VuLinh011218/LedCube8x8x8/Hardware/Image/C_25.png

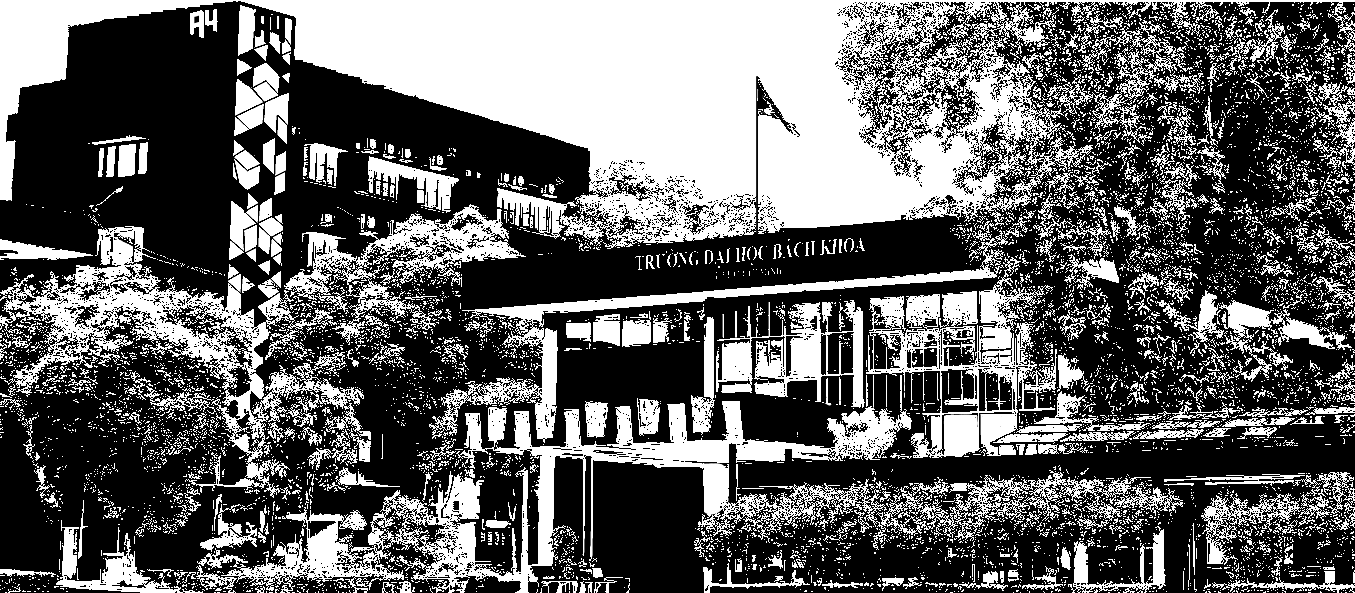
Hardware/Image/C_25.png
