VuLinh011218/LedCube8x8x8/Hardware/Image/PIF_WHITE.png

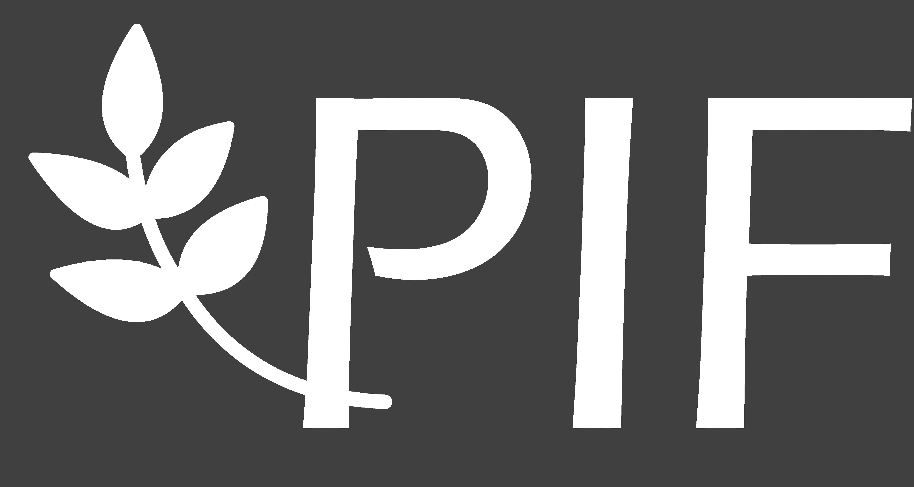
Hardware/Image/PIF_WHITE.png
