VuLinh011218/LedCube8x8x8/Hardware/Image/ImageToStl.com_7d02fde578674ff1ba44a5747493c69b/Logo_H_Bach_Khoa-HCMUT2.dxf

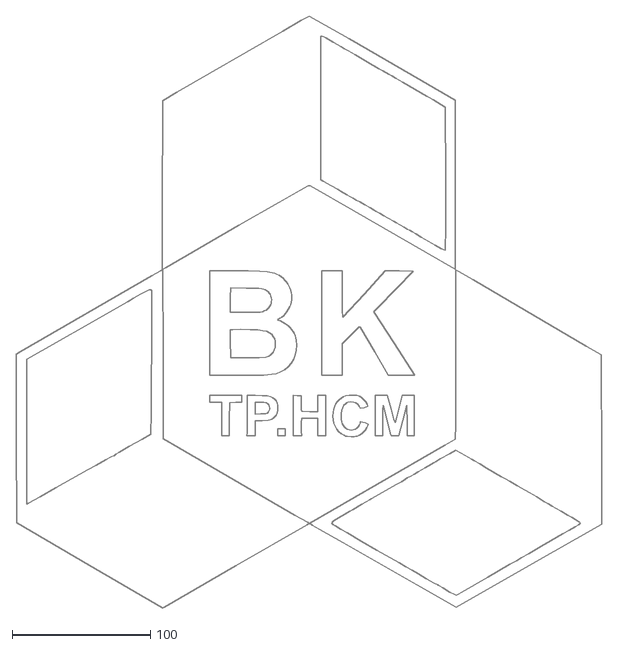
[picture p65: CAD file, 2026-07-12]
Hardware/Image/ImageToStl.com_7d02fde578674ff1ba44a5747493c69b/Logo_H_Bach_Khoa-HCMUT2.dxf
422.7 x 427.5
