VuLinh011218/LedCube8x8x8/Hardware/Image/ImageToStl.com_7d02fde578674ff1ba44a5747493c69b/ImageToStl.com_Logo_H_Bach_Khoa-HCMUT2_bottom.dxf

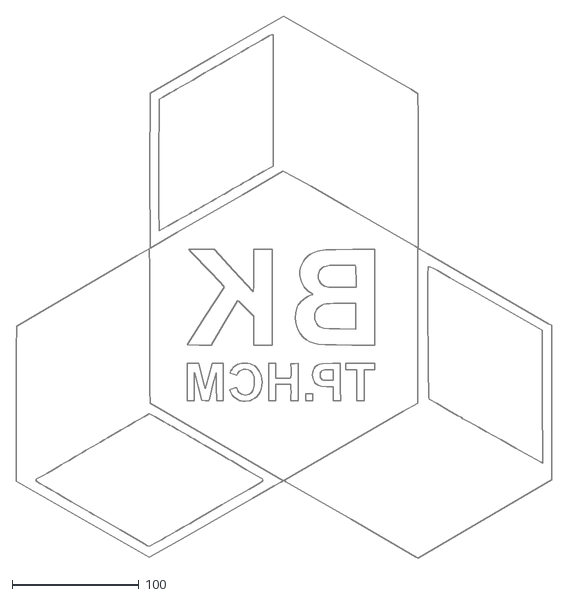
[picture p66: CAD file, 2026-07-12]
Hardware/Image/ImageToStl.com_7d02fde578674ff1ba44a5747493c69b/ImageToStl.com_Logo_H_Bach_Khoa-HCMUT2_bottom.dxf
422.7 x 427.6
