VuLinh011218/LedCube8x8x8/Hardware/Image/ImageToStl.com_7d02fde578674ff1ba44a5747493c69b/logo5.dxf

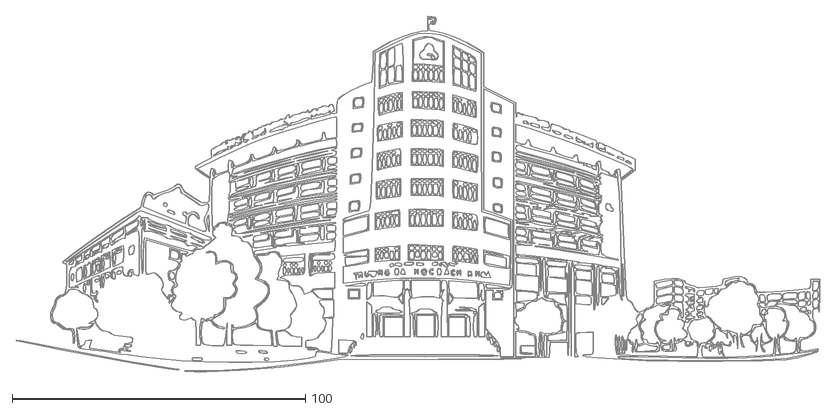
[picture p67: CAD file, 2026-07-12]
Hardware/Image/ImageToStl.com_7d02fde578674ff1ba44a5747493c69b/logo5.dxf
274.1 x 121.4
