VuLinh011218/LedCube8x8x8/Hardware/Image/ImageToStl.com_7d02fde578674ff1ba44a5747493c69b/ImageToStl.com_PIF_WHITE.dxf

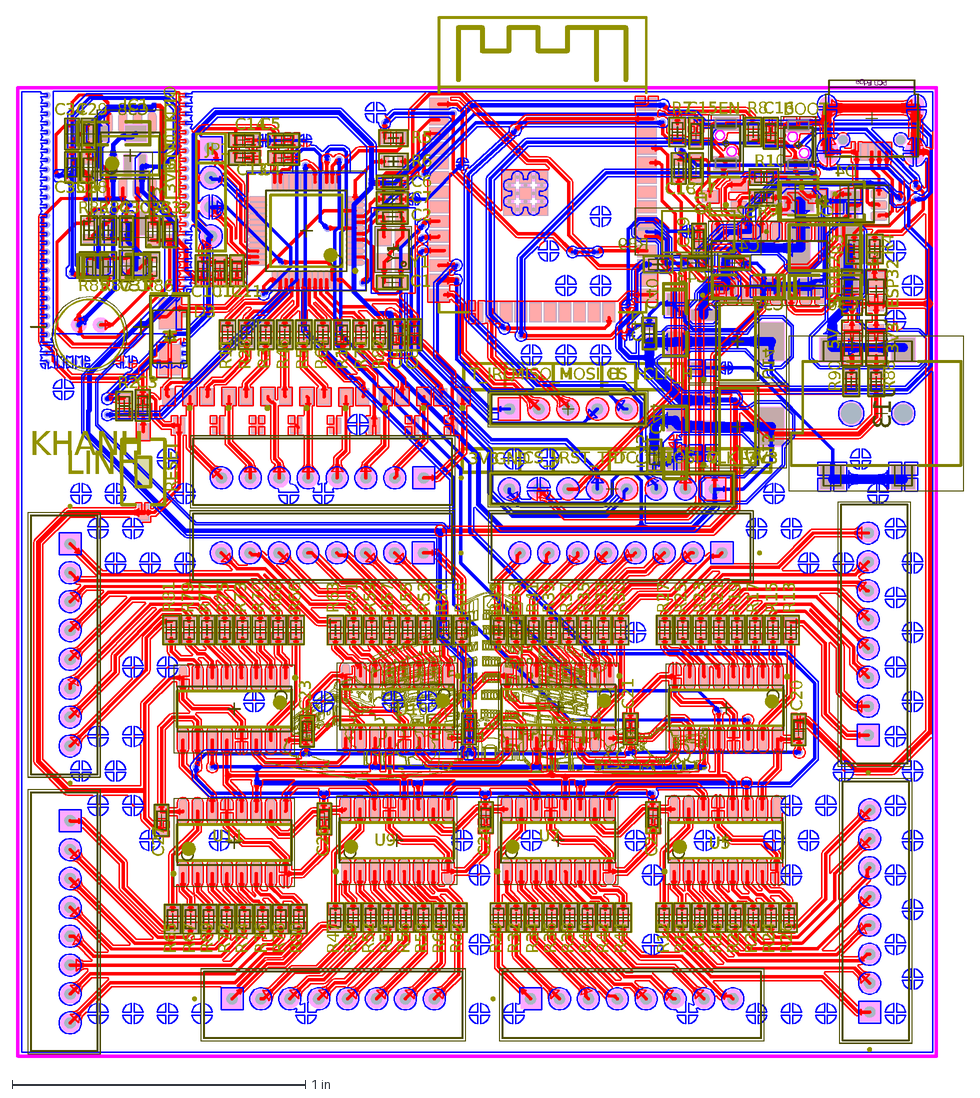
[picture p68: CAD file, 2026-07-12]
Hardware/Image/ImageToStl.com_7d02fde578674ff1ba44a5747493c69b/ImageToStl.com_PIF_WHITE.dxf
ESP32
GND
S2
R89
C43
C35
C34
C33
C32
C5
C4
Y1
U15
U14
U13
RST_TFT
U11
U10
U9
CS_V
U7
MOSI_V
U5
MOSI_H
DIO
RESET
R90
R88
R87
R86
R85
R84
R83
R82
R81
R80
R79
R78
R77
R76
R75
R74
R73
R72
R71
R70
R69
R68
R67
R66
R65
R64
R63
R62
R61
R60
R59
R58
R57
R56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
