VuLinh011218/LedCube8x8x8/Hardware/Schematic_PDF/Ledcube_8x8x8.pdf

A A

# PA0-WKUP 10

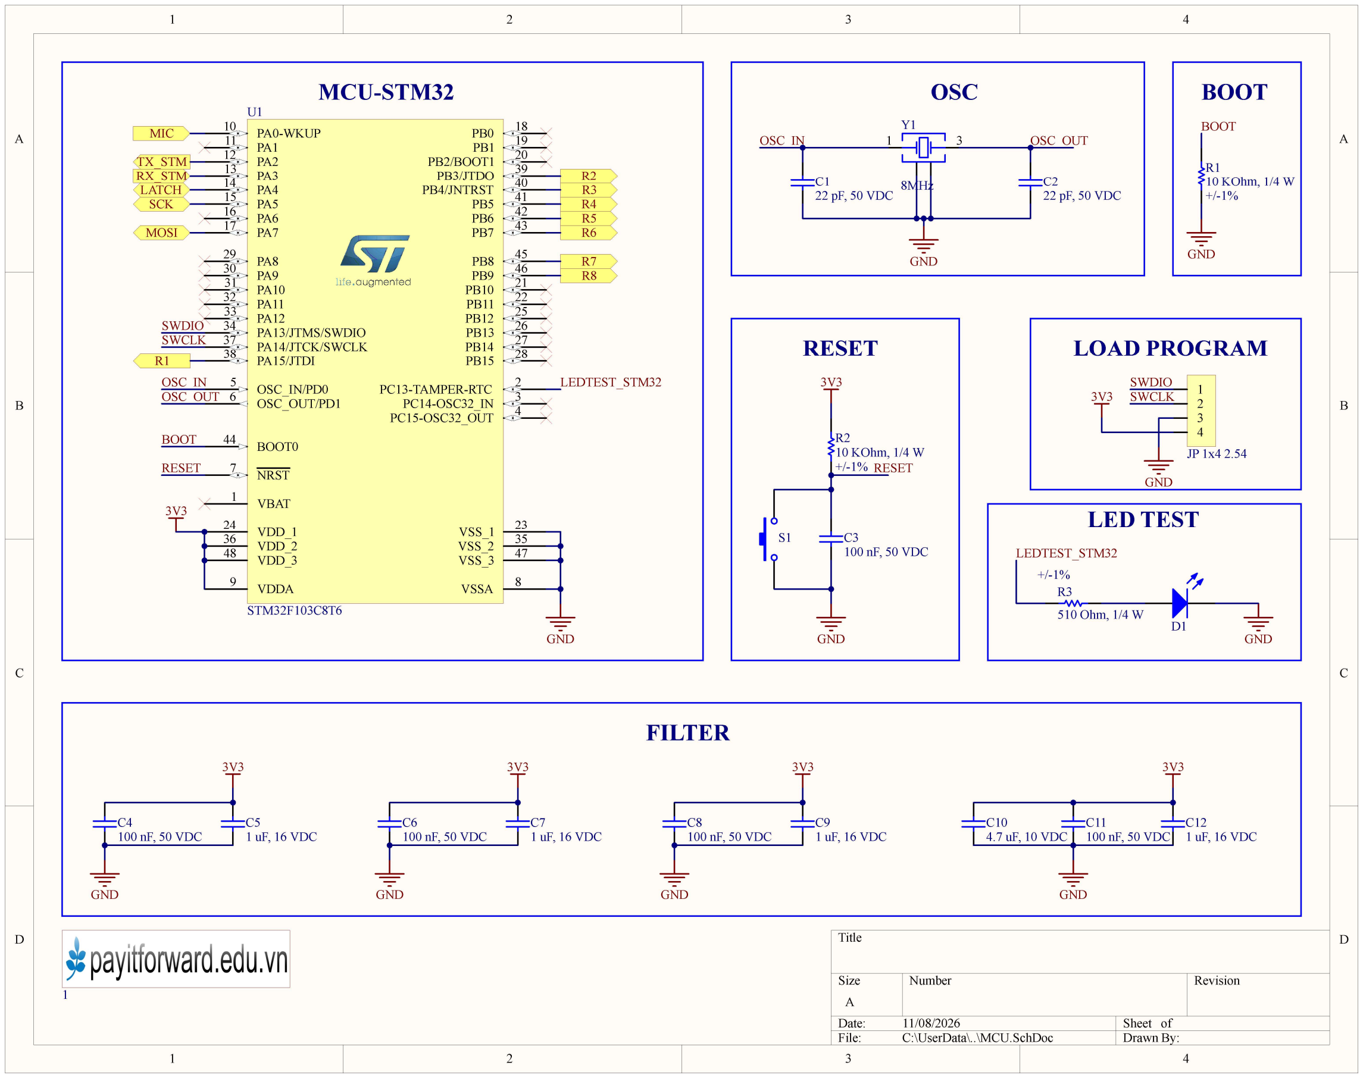
[picture p76: page 1]

1

2

3

4

D D

C C

B B

# Title

Size | Number | Revision
A
Date: | 11/08/2026 | Sheet of
File: | C:\UserData\..\MCU.SchDoc | Drawn By:

# GND

# BOOT0 44

# NRST 7

# OSC_IN/PD0 5 OSC_OUT/PD1 6

PA1 11
PA2 12
PA3 13
PA4 14
PA5 15
PA6 16
PA7 17

PA8 29
PA9 30
PA10 31
PA11 32
PA12 33

# PA13/JTMS/SWDIO 34 PA14/JTCK/SWCLK 37 PA15/JTDI 38

PB0 | 18
PB1 | 19
PB2/BOOT1 | 20
PB3/JTDO | 39
PB4/JNTRST | 40
PB5 | 41
PB6 | 42
PB7 | 43
PB8 | 45
PB9 | 46
PB10 | 21
PB11 | 22
PB12 | 25
PB13 | 26
PB14 | 27
PB15 | 28
PC13-TAMPER-RTC | 2
PC14-OSC32_IN | 3
PC15-OSC32_OUT | 4

# VBAT 1

# VDD_1 24 VDD_2 36 VDD_3 48

# VDDA 9

VSS_1 | 23
VSS_2 | 35
VSS_3 | 47
VSSA | 8

U1

# STM32F103C8T6

3V3

# SWDIO

SWCLK | 1
| 2
| 3
| 4
| JP 1x4 2.54

# GND

# RESET

GND | GND | GND

3V3

# GND

# GND

# OSC_OUT

D1

# LEDTEST_STM32

# OSC_IN

# BOOT

S1

3V3 | 3V3 | 3V3

1 3

Y1

# 8MHz

# GND

+/-1%

R1

# 10 KOhm, 1/4 W

+/-1%

R2

# 10 KOhm, 1/4 W

C12

# 1 uF, 16 VDC

C9

# 1 uF, 16 VDC

C7

# 1 uF, 16 VDC

+/-1%
R3

# 510 Ohm, 1/4 W

C11

# 100 nF, 50 VDC

C8

# 100 nF, 50 VDC

C6

# 100 nF, 50 VDC

C3

# 100 nF, 50 VDC

C1

# 22 pF, 50 VDC

C2

# 22 pF, 50 VDC

C10

# 4.7 uF, 10 VDC

# FILTER

# LED TEST

RESET | LOAD PROGRAM
MCU-STM32 | OSC | BOOT

# MIC

# TX_STM RX_STM LATCH SCK

# MOSI

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
# GND

3V3

# OSC_IN OSC_OUT

# BOOT

# RESET

# LEDTEST_STM32

# SWDIO SWCLK

# GND

3V3

C5

# 1 uF, 16 VDC

C4

# 100 nF, 50 VDC

A A

# U2 ESP32-WROOM-32E

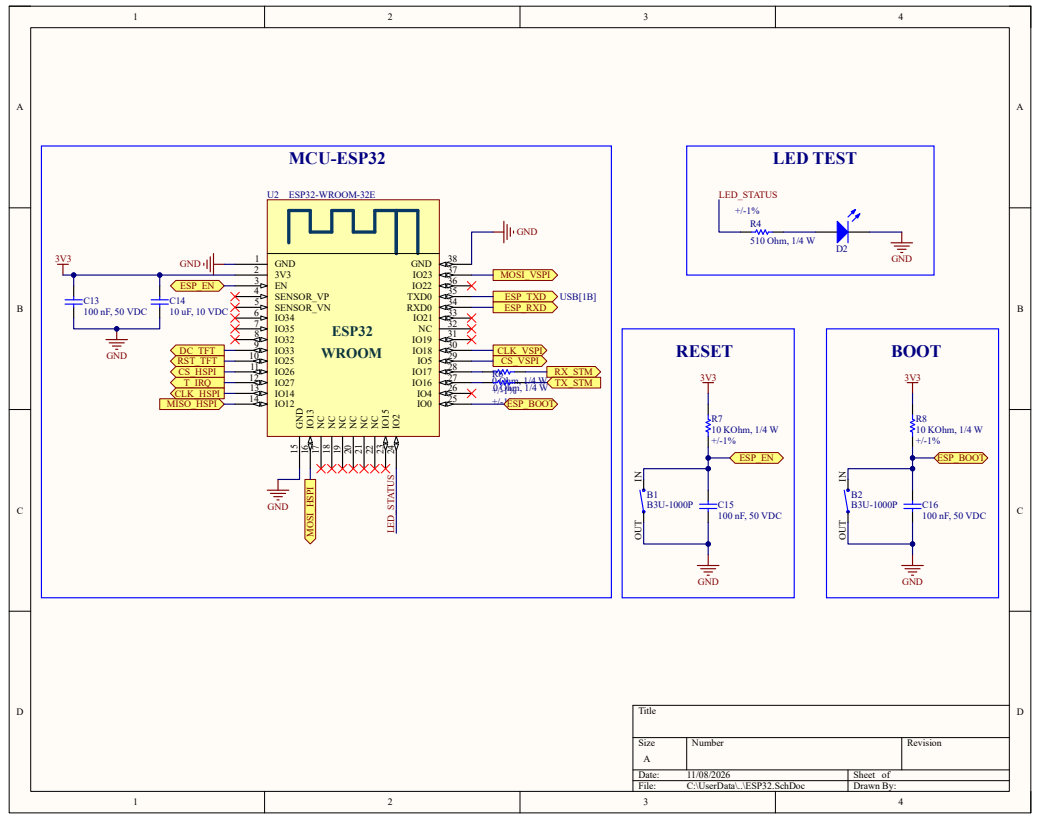
[picture p77: page 2]

A A
5V

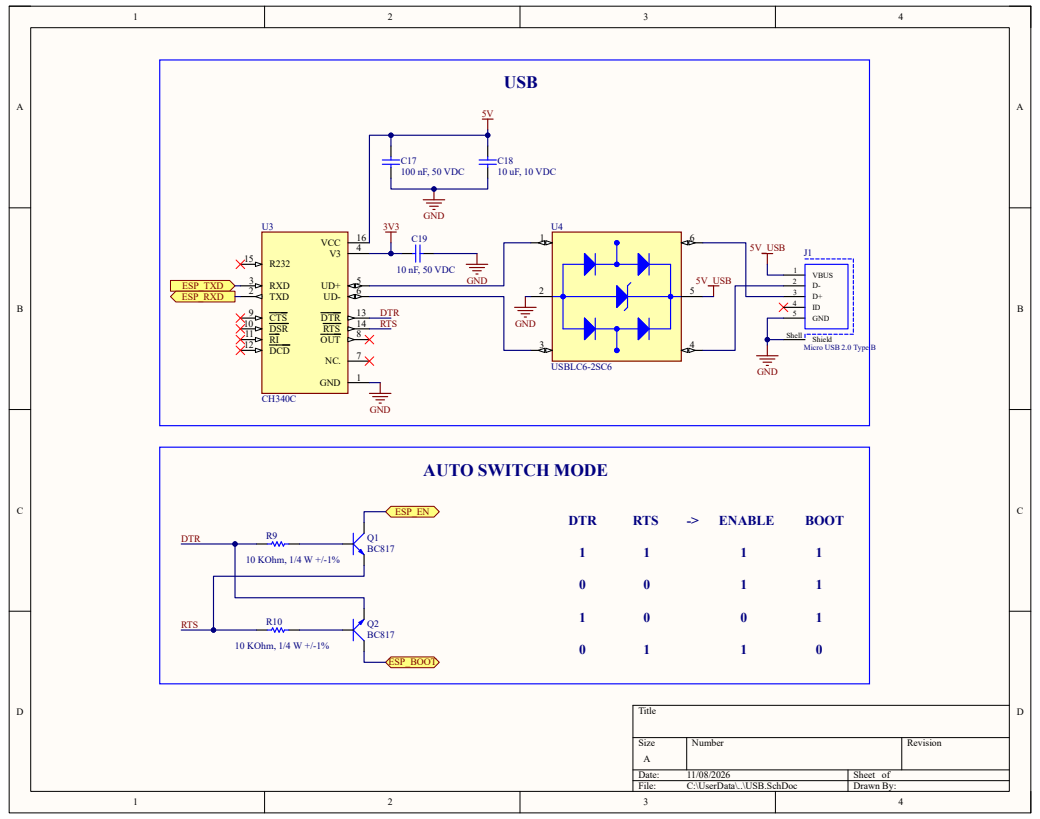
[picture p78: page 3]

# TFT

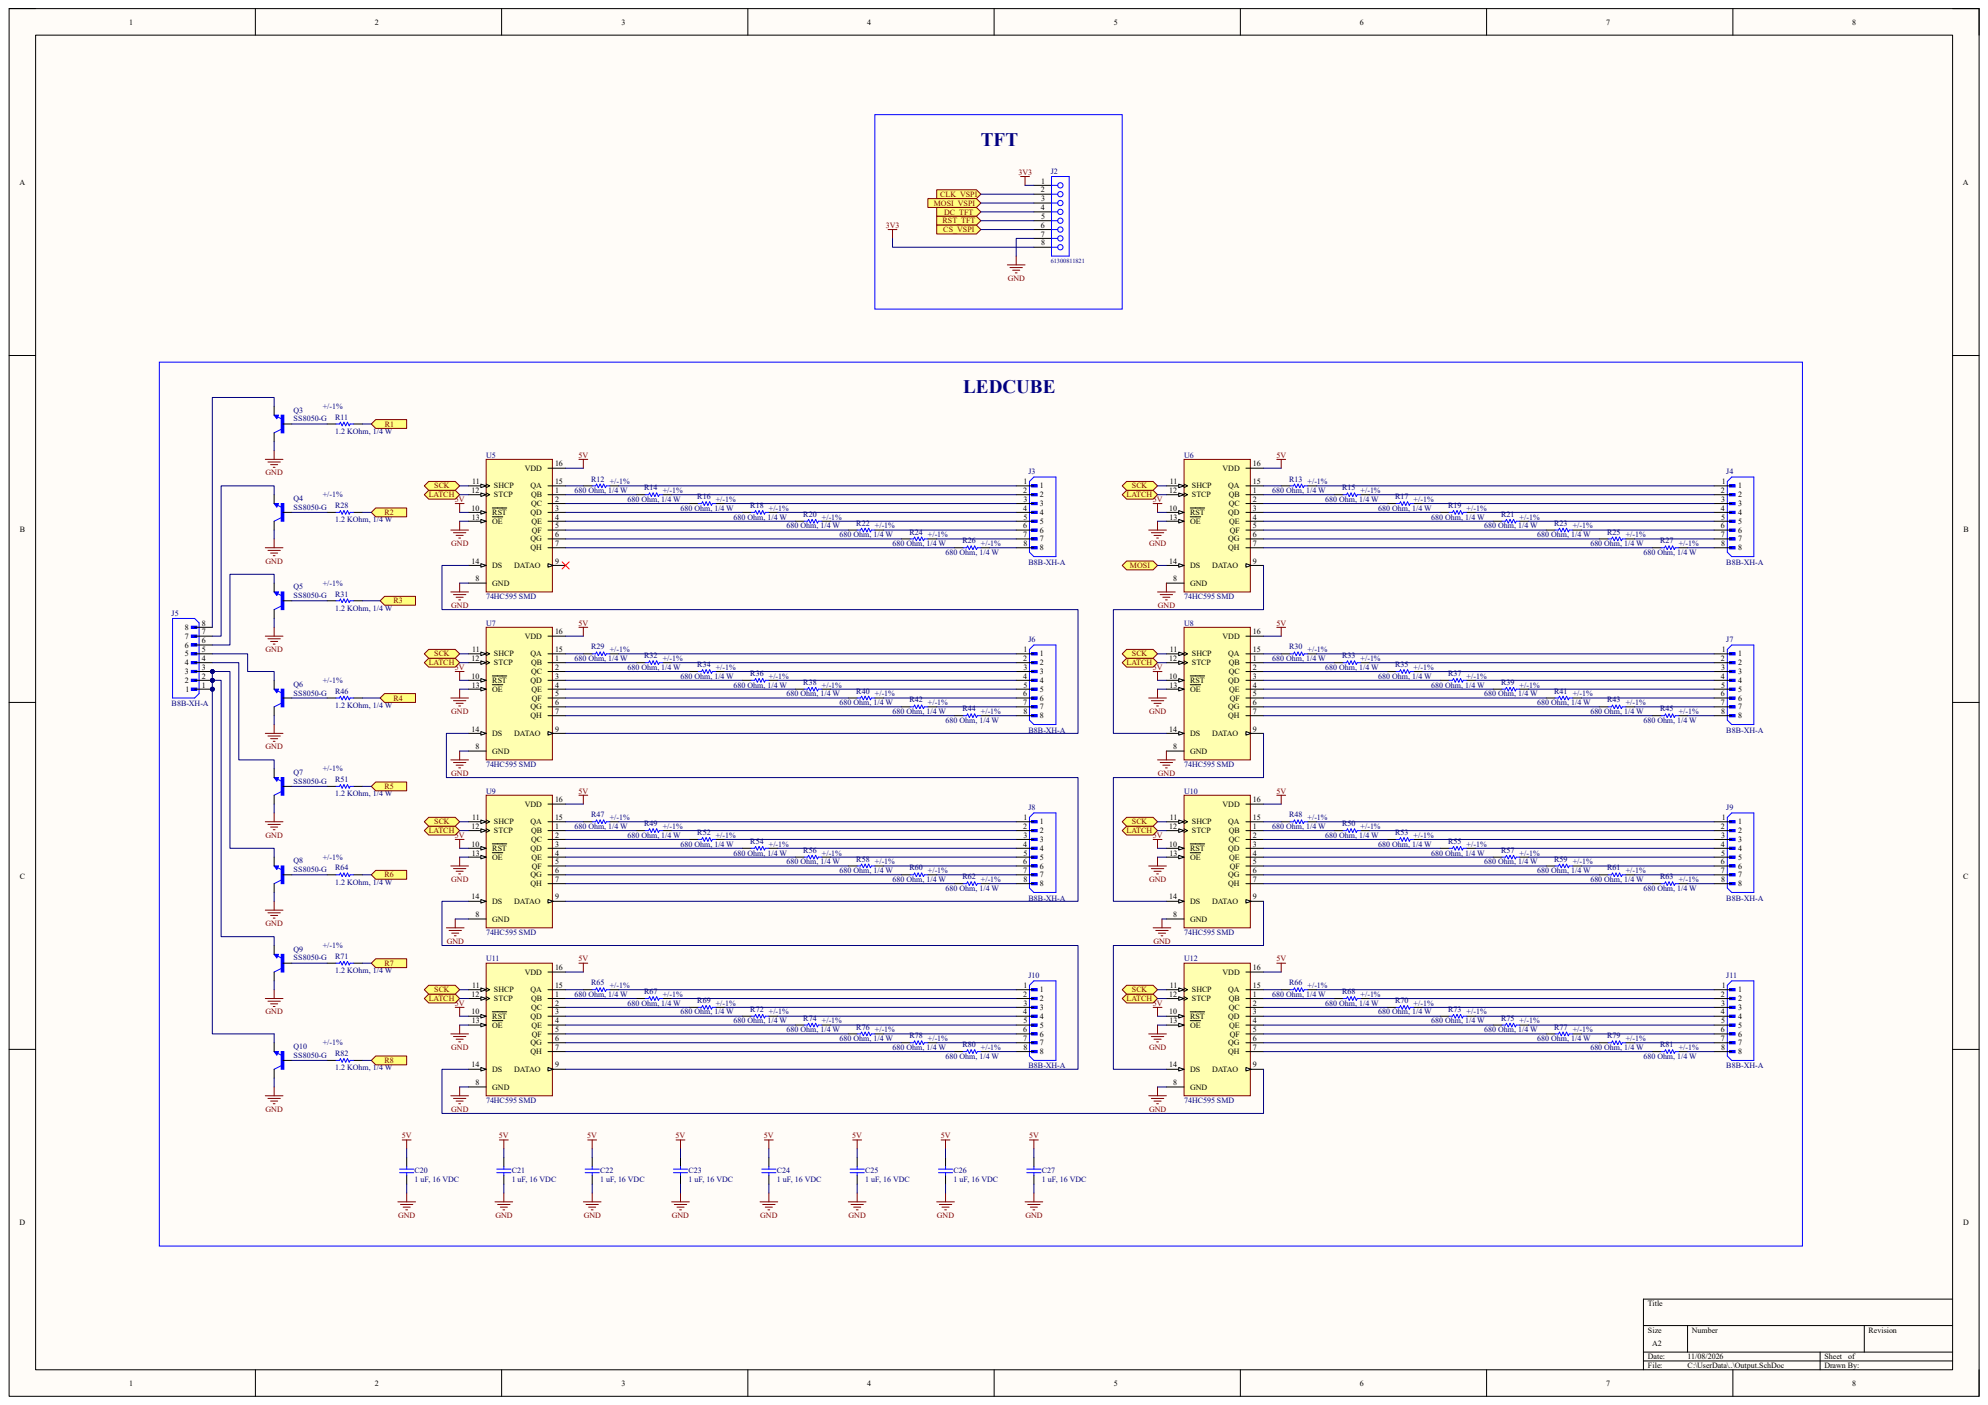
[picture p79: page 4]

A A

C29

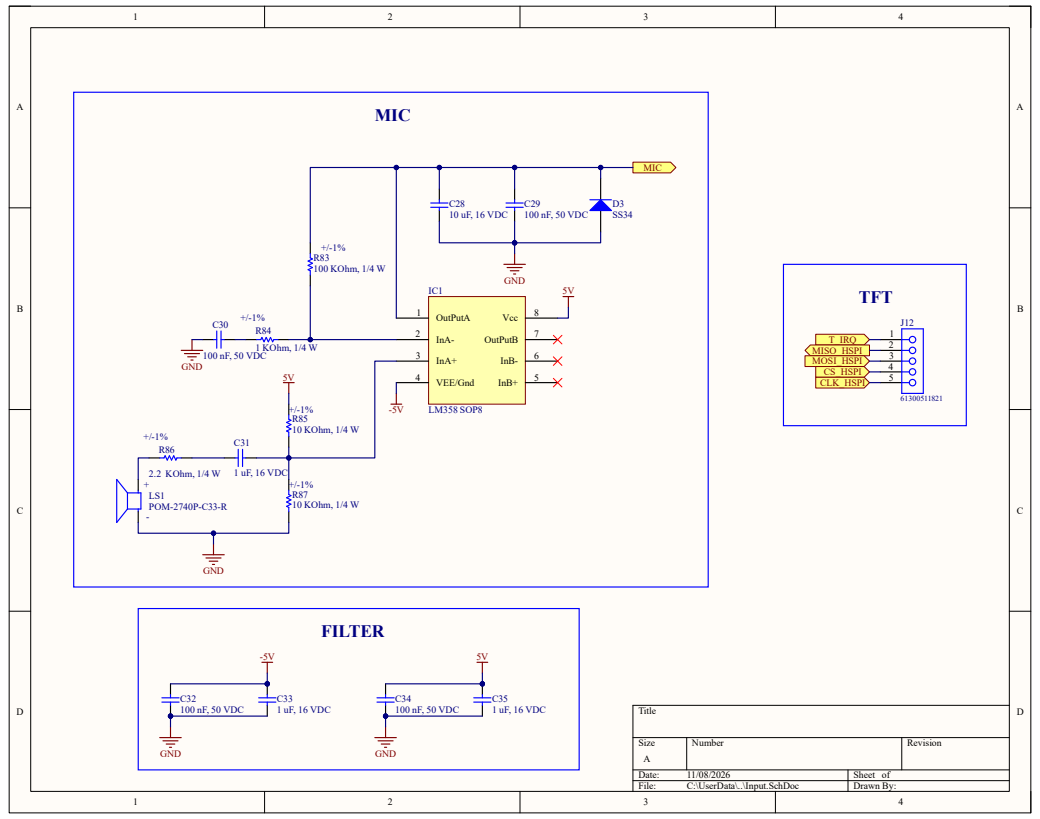
[picture p80: page 5]

A A

F1

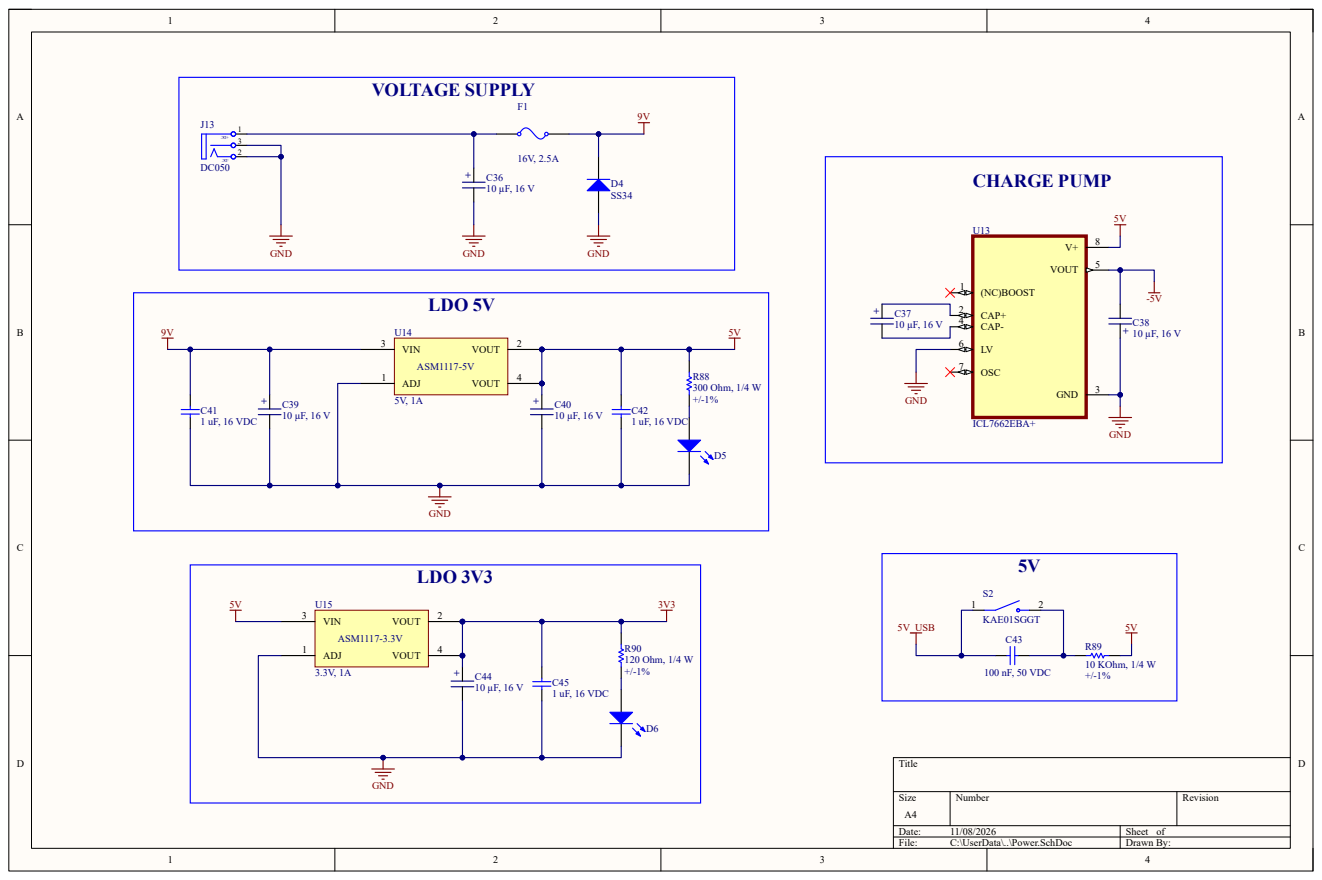
[picture p81: page 6]
