VuLinh011218/LedCube8x8x8/(list of files, drawings)

Other design files:
Hardware/Design/Design/ESP32.SchDoc
Hardware/Design/Design/Input.SchDoc
Hardware/Design/Design/ledcube_v2.PcbDoc
Hardware/Design/Design/MCU.SchDoc
Hardware/Design/Design/Output.SchDoc
Hardware/Design/Design/Power.SchDoc
Hardware/Design/Design/USB.SchDoc
Hardware/Design/Design/ver2_15_07_2025.PrjPcb
Hardware/Design/Output.SchDoc
