VuLinh011218/LedCube8x8x8/Firmware/STM32/ledcube/Core/Src/main.c

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
/* Includes ------------------------------------------------------------------*/
#include <app_comms.h>
#include <display_led.h>
#include <effects_manager.h>
#include <string.h>
#include "main.h"
/* USER CODE BEGIN Includes */
#include "min.h"

#include "min_port.h"
/* USER CODE END Includes */

/* USER CODE BEGIN PD */
#define STATUS_LED_PIN  GPIO_PIN_13
#define STATUS_LED_PORT GPIOC
/* USER CODE END PD */

ADC_HandleTypeDef hadc1;
DMA_HandleTypeDef hdma_adc1;

SPI_HandleTypeDef hspi1;

TIM_HandleTypeDef htim2;

UART_HandleTypeDef huart2;

/* USER CODE BEGIN PV */
uint8_t last_app_mode = 255;
uint8_t cube_buffer[8][8];

GPIO_TypeDef *LAYER_PORTS[8] = {GPIOB, GPIOB, GPIOB, GPIOB, GPIOB, GPIOB, GPIOB, GPIOA};
uint16_t      LAYER_PINS[8]
    = {GPIO_PIN_9, GPIO_PIN_8, GPIO_PIN_7, GPIO_PIN_6, GPIO_PIN_5, GPIO_PIN_4, GPIO_PIN_3, GPIO_PIN_15};

uint32_t last_effect_tick = 0;
/* USER CODE END PV */

void        SystemClock_Config(void);
static void MX_GPIO_Init(void);
static void MX_DMA_Init(void);
static void MX_ADC1_Init(void);
static void MX_SPI1_Init(void);
static void MX_USART2_UART_Init(void);
static void MX_TIM2_Init(void);
/* USER CODE BEGIN PFP */
void Cube_Refresh(void);
void Clear_Cube(void);
void Set_Voxel(uint8_t x, uint8_t y, uint8_t z, uint8_t state);

// Khai báo prototype các hàm hiệu ứng
void Effect_Rain_Run(uint16_t speed);
void Effect_Scan_Columns_Run(uint16_t speed);
/* USER CODE END PFP */

/* USER CODE BEGIN 0 */
#ifdef __GNUC__
int _write(int file, char *ptr, int len)
{
    return len;
}
#endif
/* USER CODE END 0 */

/**
 * @brief  The application entry point.
 * @retval int
 */
int main(void)
{

    /* MCU Configuration--------------------------------------------------------*/

    /* Reset of all peripherals, Initializes the Flash interface and the Systick. */
    HAL_Init();

    /* Configure the system clock */
    SystemClock_Config();

    /* Initialize all configured peripherals */
    MX_GPIO_Init();
    MX_DMA_Init();
    MX_ADC1_Init();
    MX_SPI1_Init();
    MX_USART2_UART_Init();
    MX_TIM2_Init();
    /* USER CODE BEGIN 2 */
    __HAL_RCC_AFIO_CLK_ENABLE();
    __HAL_AFIO_REMAP_SWJ_NOJTAG();

    App_Comms_Init();
    Effects_Manager_Init();
    Clear_Cube();
    Set_Voxel(0, 0, 0, 1);
    /* USER CODE END 2 */

    /* Infinite loop */
    /* USER CODE BEGIN WHILE */
    while (1)
    {
        /* USER CODE END WHILE */

        /* USER CODE BEGIN 3 */
        Cube_Refresh();

        extern volatile uint8_t current_mode;
        // extern volatile uint16_t current_speed;

        if (current_mode != last_app_mode)
        {
            Effects_Manager_SetMode((CubeMode_t)current_mode);
            last_app_mode = current_mode;
        }

        Effects_Manager_Run();
    }
    /* USER CODE END 3 */
}

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
/* USER CODE BEGIN 4 */
void Clear_Cube(void)
{
    memset(cube_buffer, 0, sizeof(cube_buffer));
}

// Function to turn on/off a single LED at speed (x,y,z)
void Set_Voxel(uint8_t x, uint8_t y, uint8_t z, uint8_t state)
{
    if (x > 7 || y > 7 || z > 7)
    {
        return;
    }
    if (state)
    {
        cube_buffer[z][y] |= (1 << x);
    }
    else
    {
        cube_buffer[z][y] &= ~(1 << x);
    }
}

// Function to send data to IC 74HC595
void Shift_Registers_Output(uint8_t *data_arr)
{
    HAL_SPI_Transmit(&hspi1, data_arr, 8, 10);
    HAL_GPIO_WritePin(GPIOA, GPIO_PIN_4, GPIO_PIN_SET);
    for (volatile int i = 0; i < 10; i++)
        ;
    HAL_GPIO_WritePin(GPIOA, GPIO_PIN_4, GPIO_PIN_RESET);
}

// Function to turn on the Z-layer and turn off other layers.
void Layer_On(uint8_t z)
{
    for (int i = 0; i < 8; i++)
    {
        HAL_GPIO_WritePin(LAYER_PORTS[i], LAYER_PINS[i], GPIO_PIN_RESET);
    }
    if (z < 8)
    {
        HAL_GPIO_WritePin(LAYER_PORTS[z], LAYER_PINS[z], GPIO_PIN_SET);
    }
}

// Multiplexing
void Cube_Refresh(void)
{
    static uint8_t current_layer = 0;
    Layer_On(8);
    Shift_Registers_Output(cube_buffer[current_layer]);
    Layer_On(current_layer);
    // HAL_Delay(2);
    current_layer++;
    if (current_layer >= 8)
    {
        current_layer = 0;
    }
}

void Delay_Effect(uint32_t ms)
{
    uint32_t start = HAL_GetTick();
    // Vòng lặp chờ: Trong lúc chờ vẫn phải quét LED liên tục
    while ((HAL_GetTick() - start) < ms)
    {
        Cube_Refresh();
    }
}
/* USER CODE END 4 */
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
