VuLinh011218/LedCube8x8x8/Firmware/STM32/ledcube/ledcube.ioc

Mcu.UserName=STM32F103C8Tx
PA0-WKUP.Signal=ADCx_IN0
PA13.Signal=SYS_JTMS-SWDIO
PA14.Signal=SYS_JTCK-SWCLK
PA15.GPIO_Label=R1
PA15.Signal=GPIO_Output
PA2.Signal=USART2_TX
PA3.Signal=USART2_RX
PA4.GPIO_Label=Latch
PA4.Signal=GPIO_Output
PA5.Signal=SPI1_SCK
PA6.Signal=SPI1_MISO
PA7.Signal=SPI1_MOSI
PB3.GPIO_Label=R2
PB3.Signal=GPIO_Output
PB4.GPIO_Label=R3
PB4.Signal=GPIO_Output
PB5.GPIO_Label=R4
PB5.Signal=GPIO_Output
PB6.GPIO_Label=R5
PB6.Signal=GPIO_Output
PB7.GPIO_Label=R6
PB7.Signal=GPIO_Output
PB8.GPIO_Label=R7
PB8.Signal=GPIO_Output
PB9.GPIO_Label=R8
PB9.Signal=GPIO_Output
PC13-TAMPER-RTC.Signal=GPIO_Output
PD0-OSC_IN.Signal=RCC_OSC_IN
PD1-OSC_OUT.Signal=RCC_OSC_OUT
