VuLinh011218/LedCube8x8x8/Firmware/STM32/ledcube/app/effects/spiral_cube.c

#include <display_led.h>
#include <spiral_cube.h>

extern volatile uint16_t current_speed;

static rollSize_t     rollSize      = ROLL_BIGGEST;
static axis_t         axisDirection = Y_AXIS_1;
static directRotate_t directRotate  = CLOCKWISE;
static uint8_t        x = 0, y = 0;
static const uint8_t  z_all     = 8;
static uint32_t       timeStart = 0;

static void RollBiggestCounterClockWise_Handle(void);
static void RollBiggerCounterClockWise_Handle(void);
static void RollMediumCounterClockWise_Handle(void);
static void RollSmallCounterClockWise_Handle(void);
static void RollBiggestClockWise_Handle(void);
static void RollBiggerClockWise_Handle(void);
static void RollMediumClockWise_Handle(void);
static void RollSmallClockWise_Handle(void);

void SpiralCube_Set_State()
{
    Clear_Cube();
    x             = 7;
    y             = 0;
    rollSize      = ROLL_BIGGEST;
    directRotate  = CLOCKWISE;
    axisDirection = Y_AXIS_1;
    timeStart     = HAL_GetTick();
}

void SpiralCube_Handle()
{
    DisplayLed(x, y, z_all);

    if (directRotate == COUNTER_CLOCKWISE)
    {
        switch (rollSize)
        {
            case ROLL_BIGGEST:
                RollBiggestCounterClockWise_Handle();
                break;
            case ROLL_BIGGER:
                RollBiggerCounterClockWise_Handle();
                break;
            case ROLL_MEDIUM:
                RollMediumCounterClockWise_Handle();
                break;
            case ROLL_SMALL:
                RollSmallCounterClockWise_Handle();
                break;
        }
    }
    else
    {
        switch (rollSize)
        {
            case ROLL_BIGGEST:
                RollBiggestClockWise_Handle();
                break;
            case ROLL_BIGGER:
                RollBiggerClockWise_Handle();
                break;
            case ROLL_MEDIUM:
                RollMediumClockWise_Handle();
                break;
            case ROLL_SMALL:
                RollSmallClockWise_Handle();
                break;
        }
    }
}

static void RollBiggestCounterClockWise_Handle()
{
    if (HAL_GetTick() - timeStart >= current_speed)
    {
        timeStart = HAL_GetTick();
        switch (axisDirection)
        {
            case Y_AXIS_1:
                if (y == 7)
                {
                    axisDirection = X_AXIS_1;
                }
                else
                {
                    y++;
                }
                break;
            case X_AXIS_1:
                if (x == 7)
                {
                    axisDirection = Y_AXIS_2;
                }
                else
                {
                    x++;
                }
                break;
            case Y_AXIS_2:
                if (y == 0)
                {
                    axisDirection = X_AXIS_2;
                }
                else
                {
                    y--;
                }
                break;
            case X_AXIS_2:
                if (x == 1)
                {
                    axisDirection = Y_AXIS_1;
                    rollSize      = ROLL_BIGGER;
                }
                else
                {
                    x--;
                }
                break;
        }
    }
}

static void RollBiggerCounterClockWise_Handle()
{
    if (HAL_GetTick() - timeStart >= current_speed)
    {
        timeStart = HAL_GetTick();
        switch (axisDirection)
        {
            case Y_AXIS_1:
                if (y == 6)
                {
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
                    x             = 0;
                    y             = 0;
                    directRotate  = COUNTER_CLOCKWISE;
                }
                else
                {
                    y--;
                }
                break;
        }
    }
}
