VuLinh011218/LedCube8x8x8/Firmware/STM32/ledcube/app/effects/random_rain_cube.h

#ifndef __RANDOM_RAIN_CUBE_H
#define __RANDOM_RAIN_CUBE_H

#include "main.h"
#include <stdlib.h>

void RandomRainCube_Handle(uint8_t rain_times);
void RandomRainCube_Set_State(void);

void DisplayLed(uint8_t x, uint8_t y, uint8_t z);

#endif
