VuLinh011218/LedCube8x8x8/Firmware/STM32/ledcube/app/effects/spiral_cube.h

#ifndef __SPIRAL_CUBE_H
#define __SPIRAL_CUBE_H

#include "main.h"

typedef enum {
    ROLL_BIGGEST = 0,
    ROLL_BIGGER,
    ROLL_MEDIUM,
    ROLL_SMALL
} rollSize_t;

typedef enum {
    Y_AXIS_1 = 0,
    X_AXIS_1,
    Y_AXIS_2,
    X_AXIS_2
} axis_t;

typedef enum {
    CLOCKWISE = 0,
    COUNTER_CLOCKWISE
} directRotate_t;

void SpiralCube_Handle(void);
void SpiralCube_Set_State(void);

void DisplayLed(uint8_t x, uint8_t y, uint8_t z);
void Clear_Cube(void);

#endif
