VuLinh011218/LedCube8x8x8/(notices)

Notices in the files:
Firmware/STM32/ledcube/Core/Src/main.c:
Copyright (c) 2026 STMicroelectronics.
All rights reserved.
This software is licensed under terms that can be found in the LICENSE file
